bestxiangest/Intelligent-Guide-Cane/wx/images/3d.png

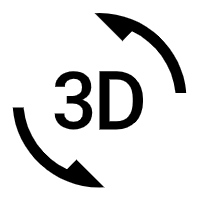
wx/images/3d.png
