bestxiangest/Intelligent-Guide-Cane/wx/images/current_position.png

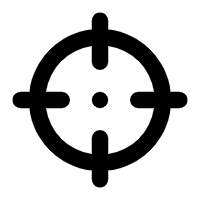
wx/images/current_position.png
