bestxiangest/Intelligent-Guide-Cane/wx/images/des.png

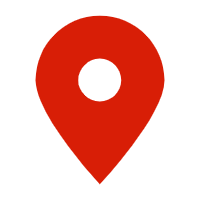
wx/images/des.png
