bestxiangest/Intelligent-Guide-Cane/wx/images/map.png

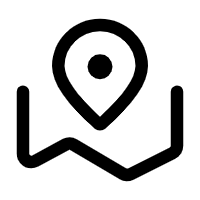
wx/images/map.png
