bestxiangest/Intelligent-Guide-Cane/wx/images/my.png

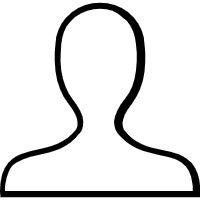
wx/images/my.png
