bestxiangest/Intelligent-Guide-Cane/wx/images/point.png

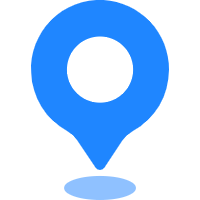
wx/images/point.png
