bestxiangest/Intelligent-Guide-Cane/wx/images/stick.png

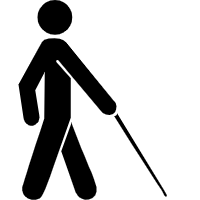
wx/images/stick.png
