bestxiangest/Intelligent-Guide-Cane/wx/images/video.png

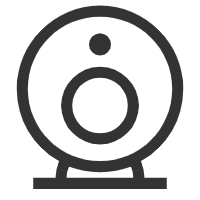
wx/images/video.png
