bestxiangest/Intelligent-Guide-Cane/src/voice.cpp

#include "voice.h"

i2s_config_t i2sIn_config = {
    .mode = i2s_mode_t(I2S_MODE_MASTER | I2S_MODE_RX),
    .sample_rate = SAMPLE_RATE,
    .bits_per_sample = i2s_bits_per_sample_t(16),
    .channel_format = I2S_CHANNEL_FMT_ONLY_LEFT,
    .communication_format = i2s_comm_format_t(I2S_COMM_FORMAT_STAND_I2S),
    .intr_alloc_flags = ESP_INTR_FLAG_LEVEL1,
    .dma_buf_count = 4,
    .dma_buf_len = 512};

const i2s_pin_config_t i2sIn_pin_config = {
    .bck_io_num = INMP441_SCK,
    .ws_io_num = INMP441_WS,
    .data_out_num = -1,
    .data_in_num = INMP441_SD};

i2s_config_t i2sOut_config = {
    .mode = i2s_mode_t(I2S_MODE_MASTER | I2S_MODE_TX),
    .sample_rate = SAMPLE_RATE,
    .bits_per_sample = i2s_bits_per_sample_t(16),
    .channel_format = I2S_CHANNEL_FMT_ONLY_RIGHT,
    .communication_format = i2s_comm_format_t(I2S_COMM_FORMAT_STAND_I2S),
    .intr_alloc_flags = ESP_INTR_FLAG_LEVEL1,
    .dma_buf_count = 6,
    .dma_buf_len = 1024};

const i2s_pin_config_t i2sOut_pin_config = {
    .bck_io_num = MAX98357_BCLK,
    .ws_io_num = MAX98357_LRC,
    .data_out_num = MAX98357_DIN,
    .data_in_num = -1};

// 初始化I2S
void set_i2s()
{
  esp_err_t err;
  
  // 先卸载可能存在的I2S驱动
  i2s_driver_uninstall(I2S_NUM_0);
  i2s_driver_uninstall(I2S_NUM_1);
  
  // 添加延迟确保驱动完全卸载
  vTaskDelay(pdMS_TO_TICKS(100));
  
  // 初始化I2S输入 (麦克风)
  Serial.println("正在初始化I2S输入驱动...");
  err = i2s_driver_install(I2S_NUM_0, &i2sIn_config, 0, NULL);
  if (err != ESP_OK) {
    Serial.printf("I2S输入驱动安装失败: %s\n", esp_err_to_name(err));
    return;
  }
  
  err = i2s_set_pin(I2S_NUM_0, &i2sIn_pin_config);
  if (err != ESP_OK) {
    Serial.printf("I2S输入引脚配置失败: %s\n", esp_err_to_name(err));
    return;
  }
  Serial.println("I2S输入驱动初始化成功");
  
  // 添加延迟
  vTaskDelay(pdMS_TO_TICKS(50));
  
  // 初始化I2S输出 (扬声器)
  Serial.println("正在初始化I2S输出驱动...");
  err = i2s_driver_install(I2S_NUM_1, &i2sOut_config, 0, NULL);
  if (err != ESP_OK) {
    Serial.printf("I2S输出驱动安装失败: %s\n", esp_err_to_name(err));
    return;
  }
  
  err = i2s_set_pin(I2S_NUM_1, &i2sOut_pin_config);
  if (err != ESP_OK) {
    Serial.printf("I2S输出引脚配置失败: %s\n", esp_err_to_name(err));
    return;
  }
  Serial.println("I2S输出驱动初始化成功");
  
  // 清空DMA缓冲区
  i2s_zero_dma_buffer(I2S_NUM_0);
  i2s_zero_dma_buffer(I2S_NUM_1);
  
  Serial.println("I2S音频系统初始化完成");
}

// 播放声音
// audioData: PCM原始数据的指针
// audioDataSize: size of PCM data
void playAudio(uint8_t *audioData, size_t audioDataSize)
{
  if (audioDataSize > 0)
  {
    size_t bytes_written = 0;
    size_t total_written = 0;
    
    // 确保所有数据都被写入
    while (total_written < audioDataSize)
    {
      esp_err_t result = i2s_write(I2S_NUM_1, 
                                   (int16_t *)(audioData + total_written), 
                                   audioDataSize - total_written, 
                                   &bytes_written, 
                                   pdMS_TO_TICKS(100));
      
      if (result != ESP_OK)
      {
        Serial.printf("[音频播放] I2S写入错误: %s\n", esp_err_to_name(result));
        break;
      }
      
      total_written += bytes_written;
      
      // 如果没有写入任何数据，稍作延迟避免忙等待
      if (bytes_written == 0)
      {
        vTaskDelay(pdMS_TO_TICKS(1));
      }
    }
  }
}

// 清空I2S DMA缓冲区
void clearAudio(void)
{
  // 清空I2S DMA缓冲区
  i2s_zero_dma_buffer(I2S_NUM_1);
  Serial.print("clearAudio");
}

// Play audio data using MAX98357A
// decode_data: base64解码后的数据
// note: base64编码的音频数据
void playAudio_fromBase64(uint8_t *decode_data, const char *note)
{
  // base64 解析
  int decoded_length = decode_base64((unsigned char *)note, (unsigned char *)decode_data);
  // 播放
  playAudio(decode_data, decoded_length);
  // delay 200ms
  delay(200);
  // 清空I2S DMA缓冲区
  clearAudio();
}

// 获取百度云平台的AccessToken
String getAccessToken_baidu()
{
  Serial.println("[语音服务] 开始获取百度AccessToken...");
  
  // 创建安全客户端
  WiFiClientSecure *client = new WiFiClientSecure;
  if (!client)
  {
    Serial.println("[语音服务] 错误：无法创建HTTPS客户端");
    return "";
  }
  
  // 跳过证书验证
  client->setInsecure();
  
  // 设置连接超时
  client->setTimeout(10); // 10秒超时
  
  // 创建HTTP客户端
  HTTPClient https;
  String accessToken = "";

  // 百度API请求地址
  const char *target_url = "https://aip.baidubce.com/oauth/2.0/token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";
  
  Serial.println("[语音服务] 连接到百度API服务器...");
  https.begin(*client, target_url);
  
  // 设置HTTP超时
  https.setTimeout(10000); // 10秒超时
  
  https.addHeader("Content-Type", "application/json");
  https.addHeader("Accept", "application/json");

  // 构造空JSON字符串负载
  String payload = "\"\"";
  
  // Serial.println("[语音服务] 发送POST请求...");
  int httpCode = https.POST(payload);
  
  // Serial.printf("[语音服务] HTTP响应代码: %d\n", httpCode);

  if (httpCode > 0)
  {
    if (httpCode == HTTP_CODE_OK || httpCode == HTTP_CODE_MOVED_PERMANENTLY)
    {
      String response = https.getString();
      // Serial.println("[语音服务] 收到响应: " + response);
      
      DynamicJsonDocument doc(1024);
      DeserializationError error = deserializeJson(doc, response);
      
      if (error) {
        Serial.printf("[语音服务] JSON解析错误: %s\n", error.c_str());
      } else {
        accessToken = doc["access_token"].as<String>();
        if (accessToken.length() > 0) {
          Serial.println("[语音服务] ✓ 获取AccessToken成功");
        } else {
          Serial.println("[语音服务] 错误：响应中没有access_token");
        }
      }
    }
    else
    {
      Serial.printf("[语音服务] HTTP请求失败，错误代码: %d, 错误信息: %s\n", 
                    httpCode, https.errorToString(httpCode).c_str());
    }
  }
  else
  {
    Serial.printf("[语音服务] 连接失败，错误代码: %d, 错误信息: %s\n", 
                  httpCode, https.errorToString(httpCode).c_str());
  }
  
  https.end();
  delete client;
  
  if (accessToken.length() == 0) {
    Serial.println("[语音服务] ✗ AccessToken获取失败，语音服务将无法使用");
  }
  Serial.println("token为:" + accessToken);

  return accessToken;
}

// 百度语音识别
// accessToken: 百度云平台的AccessToken
// audioData: PCM原始数据的指针
// audioDataSize: size of PCM data
String baidu_voice_recognition(String accessToken, uint8_t *audioData, int audioDataSize)
{
  String recognizedText = "";

  if (accessToken == "")
  {
    Serial.println("access_token is null");
    return recognizedText;
  }

  // audio数据包许愿哦进行Base64编码，数据量会增大1/3
  int audio_data_len = audioDataSize * sizeof(char) * 1.4;
  unsigned char *audioDataBase64 = (unsigned char *)ps_malloc(audio_data_len);
  if (!audioDataBase64)
  {
    Serial.println("Failed to allocate memory for audioDataBase64");
    return recognizedText;
  }

  // json包大小，由于需要将audioData数据进行Base64的编码，数据量会增大1/3
  int data_json_len = audioDataSize * sizeof(char) * 1.4;
  char *data_json = (char *)ps_malloc(data_json_len);
  if (!data_json)
  {
    Serial.println("Failed to allocate memory for data_json");
    return recognizedText;
  }

  // Base64 encode audio data
  encode_base64(audioData, audioDataSize, audioDataBase64);

  memset(data_json, '\0', data_json_len);
  strcat(data_json, "{");
  strcat(data_json, "\"format\":\"pcm\",");
  strcat(data_json, "\"rate\":16000,");
  strcat(data_json, "\"dev_pid\":1537,");
  strcat(data_json, "\"channel\":1,");
  strcat(data_json, "\"cuid\":\"57722200\",");
  strcat(data_json, "\"token\":\"");
  strcat(data_json, accessToken.c_str());
  strcat(data_json, "\",");
  sprintf(data_json + strlen(data_json), "\"len\":%d,", audioDataSize);
  strcat(data_json, "\"speech\":\"");
  strcat(data_json, (const char *)audioDataBase64);
  strcat(data_json, "\"");
  strcat(data_json, "}");

  // 创建http请求
  HTTPClient http_client;

  http_client.begin("http://vop.baidu.com/server_api");
  http_client.addHeader("Content-Type", "application/json");
  int httpCode = http_client.POST(data_json);

  if (httpCode > 0)
  {
    if (httpCode == HTTP_CODE_OK)
    {
      // 获取返回结果
      String response = http_client.getString();
      Serial.println(response);

      // 从json中解析对应的result
      DynamicJsonDocument responseDoc(1024);
      deserializeJson(responseDoc, response);

      // 假设 responseDoc["result"] 是一个 JSON 数组，并且你想要第一个元素
      if (responseDoc["result"].is<JsonArray>())
      {
        JsonArray resultArray = responseDoc["result"].as<JsonArray>();
        if (resultArray.size() > 0)
        {
          recognizedText = resultArray[0].as<String>();
        }
        else
        {
          Serial.println("Error: 'result' 数组为空。");
          recognizedText = ""; // 或者其他你希望的默认值
        }
      }
      else if (responseDoc["result"].is<String>())
      {
        // 如果 "result" 直接就是一个字符串，则直接赋值
        recognizedText = responseDoc["result"].as<String>();
      }
      else
      {
        Serial.println("Error: 'result' 不是一个字符串或字符串数组。");
        recognizedText = ""; // 或者其他你希望的默认值
      }
    }
  }
  else
  {
    Serial.printf("[HTTP] POST failed, error: %s\n", http_client.errorToString(httpCode).c_str());
  }

  // 释放内存
  if (audioDataBase64)
  {
    free(audioDataBase64);
  }

  if (data_json)
  {
    free(data_json);
  }

  http_client.end();

  return recognizedText;
}

// Play zai audio data using MAX98357A
void playAudio_Zai(void)
{
  const char *zai = "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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
AAAAAAAAAAAAAAAAAAAAAAAAAAAAAAAAAAAAAAAAAAAAAAAAAAAAAAAAAAAAAAAAAAAAAAAAAAAAAAAAAAAAAAAAAAAAAAAAAAAAAAAAAAAAAAAAAAAAAAAAAAAAAAAAAAAAAAAAAAAAAAAAAAAAAAAAAAAAAAAAAAAAAAAAAAAAAAAAAAAAAAAAAAAAAAAAAAAAAAAAAAAAAAAAAAAAAAAAAAAAAAAAAAAAAAAAAAAAAAAAAAAAAAAAAAAAAAAAAAAAAAAAAAAAAAAAAAAAAAAAAAAAAAAAAAAAAAAAAAAAAAAAAAAAAAAAAAAAAAAAAAAAAAAAAAAAAAAAAAAAAAAAAAAAAAAAAAAAAAAAAAAAAAAAAAAAAAAAAAAAAAAAAAAAAAAAAAAAAAAAAAAAAAAAAAAAAAAAAAAAAAAAAAAAAAAAAAAAAAAAAAAAAAAAAAAAAAAAAAAAAAAAAAAAAAAAAAAAAAAAAAAAAAAAAAAAAAAAAAAAAAAAAAAAAAAAAAAAAAAAAAAAAAAAAAAAAAAAAAAAAAAAAAAAAAAAAAAAAAAAAAAAAAAAAAAAAAAAAAAAAAAAAAAAAAAAAAAAAAAAAAAAAAAAAAAAAAAAAAAAAAAAAAAAAAAAAAAAAAAAAAAAAAAAAAAAAAAAAAAAAAAAAAAAAAAAAAAAAAAAAAAAAAAAAAAAAAAAAAAAAAAAAAAAAAAAAAAAAAAAAAAAAAAAAAAAAAAAAAAAAAAAAAAAAAAAAAAAAAAAAAAAAAAAAAAAAAAAAAAAAAAAAAAAAAAAAAAAAAAAAAAAAAAAAAAAAAAAAAAAAAAAAAAAAAAAAAAAAAAAAAAAAAAAAAAAAAAAAAAAAAAAAAAAAAAAAAAAAAAAAAAAAAAAAAAAAAAAAAAAAAAAAAAAAAAAAAAAAAAAAAAAAAAAAAAAAAAAAAAAAAAAAAAAAAAAAAAAAAAAAAAAAAAAAAAAAAAAAAAAAAAAAAAAAAAAAAAAAAAAAAAAAAAAAAAAAAAAAAAAAAAAAAAAAAAAAAAAAAAAAAAAAAAAAAAAAAAAAAAAAAAAAAAAAAAAAAAAAAAAAAAAAAAAAAAAAAAAAAAAAAAAAAAAAAAAAAAAAAAAAAAAAAAAAAAAAAAAAAAAAAAAAAAAAAAAAAAAAAAAAAAAAAAAAAAAAAAAAAAAAAAAAAAAAAAAAAAAAAAAAAAAAAAAAAAAAAAAAAAAAAAAAAAAAAAAAAAAAAAA=";

  // 分配内存
  uint8_t *decode_data = (uint8_t *)ps_malloc(16000 * 3);
  if (!decode_data)
  {
    Serial.println("Failed to allocate memory for decode_data");
    return;
  }

  // base64 解析
  int decoded_length = decode_base64((unsigned char *)zai, (unsigned char *)decode_data);

  // 播放
  playAudio(decode_data, decoded_length);

  // delay 200ms
  delay(200);

  // 清空I2S DMA缓冲区
  clearAudio();

  // 释放内存
  free(decode_data);
}

String send_to_AI(String message)
{

  // 服务器地址和路径
  const char *serverAddress = "frp-bus.com";
  const int serverPort = 24201;
  const char *serverPath = "/ai";

  if (isConnectedToWifi)
  {
    HTTPClient http;
    String responseText = " ";

    // 构建请求 URL
    String serverURL = String("https://") + serverAddress + ":" + String(serverPort) + serverPath;
    http.begin(serverURL.c_str());
    http.addHeader("Content-Type", "application/json");

    // 构建 JSON 请求体
    DynamicJsonDocument jsonDocument(1024); // 根据您的消息长度调整大小
    jsonDocument["message"] = message;
    String requestBody;
    serializeJson(jsonDocument, requestBody);

    Serial.print("发送请求到: ");
    Serial.println(serverURL);
    Serial.print("请求体: ");
    Serial.println(requestBody);

    // 发送 POST 请求
    int httpResponseCode = http.POST(requestBody);

    if (httpResponseCode > 0)
    {
      Serial.print("HTTP 响应代码: ");
      Serial.println(httpResponseCode);
      if (httpResponseCode == 200)
      {
        String responseBody = http.getString();
        Serial.print("响应体: ");
        Serial.println(responseBody);
        responseText = responseBody;
      }
      else
      {
        Serial.printf("POST 请求失败，错误代码: %d\n", httpResponseCode);
      }
    }
    else
    {
      Serial.printf("POST 请求连接失败，错误: %s\n", http.errorToString(httpResponseCode).c_str());
    }

    http.end();
    return responseText;
  }
  else
  {
    Serial.println("Wi-Fi 连接断开，无法发送请求。");
  }
  return "";
}

void baiduTTS_Send(String access_token, String text)
{
  if (access_token == "")
  {
    Serial.println("access_token is null");
    return;
  }

  if (text.length() == 0)
  {
    Serial.println("text is null");
    return;
  }

  const int per = 1;
  const int spd = 6;
  const int pit = 5;
  const int vol = 9;
  const int aue = 6;

  // 进行 URL 编码
  String encodedText = urlEncode(urlEncode(text));

  // URL http请求数据封装
  String url = "https://tsn.baidu.com/text2audio";

  const char *header[] = {"Content-Type", "Content-Length"};

  url += "?tok=" + access_token; // Token
  url += "&tex=" + encodedText;  //  需要合成的文本，tex字段2次urlencode
  url += "&per=" + String(per);  // 发音人选择, 度小宇=1，度小美=0，度逍遥（基础）=3，度丫丫=4
  url += "&spd=" + String(spd);  // 语速，取值0-15，默认为5中语速
  url += "&pit=" + String(pit);  // 音调，取值0-15，默认为5中语调
  url += "&vol=" + String(vol);  // 音量，取值0-15，默认为5中音量
  url += "&aue=" + String(aue);  // 3为mp3格式(默认)； 4为pcm-16k；5为pcm-8k；6为wav（内容同pcm-16k）; 注意aue=4或者6是语音识别要求的格式，但是音频内容不是语音识别要求的自然人发音，所以识别效果会受影响。
  url += "&cuid=gPm0ytVOuc9VpDkktWaoUEIC";
  url += "&lan=zh";
  url += "&ctp=1";

  // http请求创建
  HTTPClient http;

  http.begin(url);
  http.collectHeaders(header, 2);

  int httpResponseCode = http.GET();
  if (httpResponseCode > 0)
  {
    if (httpResponseCode == HTTP_CODE_OK)
    {
      String contentType = http.header("Content-Type");
      if (contentType.startsWith("audio"))
      {
        Serial.println("合成成功");

        uint8_t buffer[1024] = {0}; // 增大缓冲区以减少卡顿
        size_t bytesRead = 0;

        int len = http.getSize(); // 读取响应正文数据字节数，如果返回-1是因为响应头中没有Content-Length属性
        // 获取返回的音频数据流
        WiFiClient *stream = http.getStreamPtr();

        while (http.connected() && (len > 0 || len == -1)) // 当前已连接并且有数据可读
        {
          size_t size = stream->available(); // 获取数据流中可用字节数
          if (size)
          {
            int c = stream->readBytes(buffer, ((size > sizeof(buffer)) ? sizeof(buffer) : size)); // 读取数据到buffer
            playAudio(buffer, c);
            if (len > 0)
            {
              len -= c;
            }
            // 增加延迟以确保I2S有足够时间处理数据
            vTaskDelay(pdMS_TO_TICKS(10));
          }
          else
          {
            vTaskDelay(pdMS_TO_TICKS(1));
          }
        }

        // Flush and stop I2S after all data is processed
        // 清空I2S DMA缓冲区
        delay(200);
        clearAudio();
      }
      else if (contentType.equals("application/json"))
      {
        Serial.println("合成出现错误");
        String response = http.getString(); // Print the error JSON for debugging
        Serial.println(response);
      }
      else
      {
        Serial.println("未知的Content-Type: " + contentType);
      }
    }
    else
    {
      Serial.print("Error code: ");
      Serial.println(httpResponseCode);
      String response = http.getString(); // Print the error response for debugging
      Serial.println(response);
    }
  }
  else
  {
    Serial.print("Error code: ");
    Serial.println(httpResponseCode);
  }
  http.end();
}

void CosyVoice_Send(String textToSynthesize)
{
  String serverUrl = "http://101.132.166.117:5000/synthesize_pcm";
  String urlWithParams = serverUrl + "?text=" + textToSynthesize;

  if (textToSynthesize.length() == 0)
  {
    Serial.println("text is null");
    return;
  }

  const char *header[] = {"Content-Type"};

  // http请求创建
  HTTPClient http;

  http.begin(urlWithParams);
  http.collectHeaders(header, 1);

  int httpResponseCode = http.GET();  
  if (httpResponseCode > 0)
  {
    if (httpResponseCode == HTTP_CODE_OK)
    {
      String contentType = http.header("Content-Type");
      if (contentType.startsWith("audio"))
      {
        Serial.println("合成成功");

        uint8_t buffer[1024] = {0}; // 增大缓冲区以减少卡顿
        size_t bytesRead = 0;

        int len = http.getSize(); // 读取响应正文数据字节数，如果返回-1是因为响应头中没有Content-Length属性
        // 获取返回的音频数据流
        WiFiClient *stream = http.getStreamPtr();

        while (http.connected() && (len > 0 || len == -1)) // 当前已连接并且有数据可读
        {
          size_t size = stream->available(); // 获取数据流中可用字节数
          if (size)
          {
            int c = stream->readBytes(buffer, ((size > sizeof(buffer)) ? sizeof(buffer) : size)); // 读取数据到buffer
            playAudio(buffer, c);
            if (len > 0)
            {
              len -= c;
            }
            // 增加延迟以确保I2S有足够时间处理数据
            vTaskDelay(pdMS_TO_TICKS(10));
          }
          else
          {
            vTaskDelay(pdMS_TO_TICKS(1));
          }
        }

        // Flush and stop I2S after all data is processed
        // 清空I2S DMA缓冲区
        delay(200);
        clearAudio();
      }
      else if (contentType.equals("application/json"))
      {
        Serial.println("合成出现错误");
        String response = http.getString(); // Print the error JSON for debugging
        Serial.println(response);
      }
      else
      {
        Serial.println("未知的Content-Type: " + contentType);
      }
    }
    else
    {
      Serial.print("Error code: ");
      Serial.println(httpResponseCode);
      String response = http.getString(); // Print the error response for debugging
      Serial.println(response);
    }
  }
  else
  {
    Serial.print("Error code: ");
    Serial.println(httpResponseCode);
  }
  http.end();
}
