bestxiangest/Intelligent-Guide-Cane/(commit log)

2025-05-30 final commit
    省赛结束，项目完成。
2025-12-02 lib update
    添加了依赖库文件。其中lib中文件需要解压缩后使用。主要为唤醒词的训练模型
2025-12-02 final update
    优化了唤醒词唤醒逻辑，使系统更加流畅，修复了一些问题。
2026-02-12 关闭阿里云密钥
    产生了大量费用
2026-03-10 部署指南
2026-03-10 Update readme by removing wiring diagram and changing API key
    Removed wiring diagram section and updated API key information.
2026-04-28 重构低延迟语音中枢并更新项目文档
2026-04-30 增强对用户请求的响应能力，支持讲笑话、讲故事和陪聊天功能，并优化语音合成处理逻辑
